cesargrobe/carrinho-robo/apresentacao_fecon_2026_16x9_v2.png

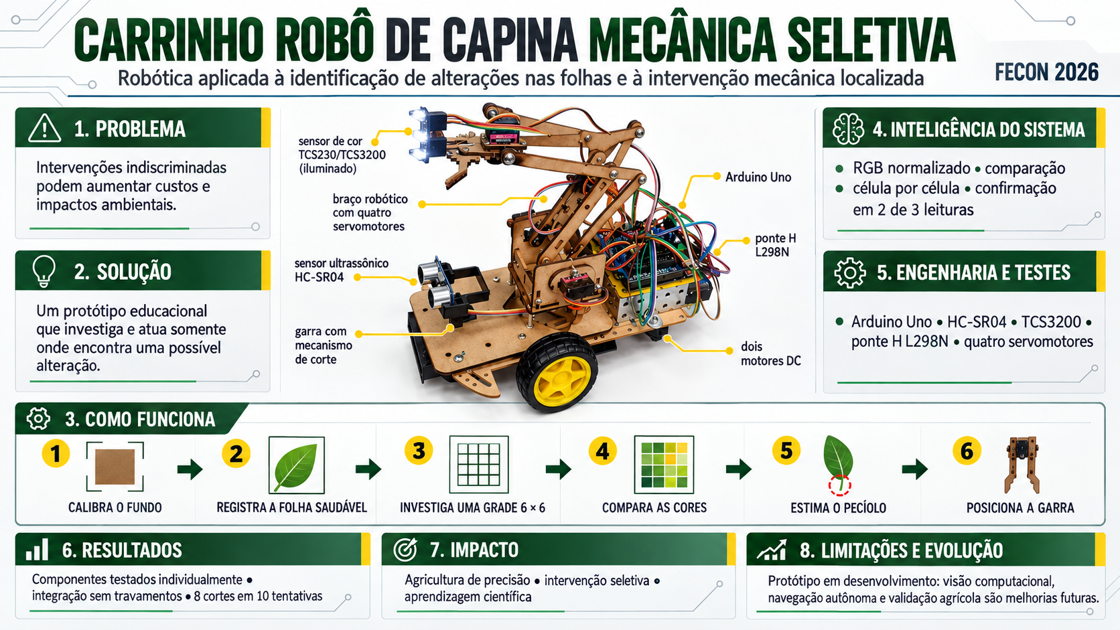
apresentacao_fecon_2026_16x9_v2.png
