cesargrobe/carrinho-robo/CALIBRACAO_BRACO_E_GRADE.xlsx

Sheet: Curva vertical
CALIBRAÇÃO DO BRAÇO E DA DISTÂNCIA DA GRADE
Ponto | Uso | Altura nominal (cm) | Altura medida (cm) | Distância 1 (cm) | Distância 2 (cm) | Distância 3 (cm) | Distância média (cm) | Erro de altura (cm) | Ombro nominal (°) | Ombro ajustado (°) | Cotovelo nominal (°) | Cotovelo ajustado (°) | Distância adequada? | Movimento seguro? | Observações
1 | Trajetória | 18.5 |  |  |  |  |  |  | 105 |  | 140
2 | Trajetória | 17.5 |  |  |  |  |  |  | 107 |  | 127
3 | Grade - linha 0 | 15 |  |  |  |  |  |  | 110 |  | 100
4 | Grade - linha 1 | 13 |  |  |  |  |  |  | 120 |  | 80
5 | Grade - linha 2 | 11 |  |  |  |  |  |  | 130 |  | 75
6 | Grade - linha 3 | 9 |  |  |  |  |  |  | 140 |  | 65
7 | Grade - linha 4 | 7 |  |  |  |  |  |  | 150 |  | 65
8 | Grade - linha 5 | 5 |  |  |  |  |  |  | 155 |  | 65
9 | Limite inferior | 2.5 |  |  |  |  |  |  | 165 |  | 40

Sheet: Grade horizontal
CALIBRAÇÃO HORIZONTAL DA GRADE 6 × 6
Coluna | Base nominal (°) | Base ajustada (°) | Posição horizontal medida (cm) | Observações
0 | 80
1 | 84
2 | 88
3 | 92
4 | 96
5 | 100

Sheet: Pecíolo
CALIBRAÇÃO DA POSE DE CORTE DO PECÍOLO
Tipo | Altura (cm) | Base (°) | Ombro (°) | Cotovelo (°) | Distância ao pecíolo (cm)
Estimativa atual | 16 | Calculada pela máscara | 109 | 111
Pose ajustada final
Resultado do fechamento / observações:

Sheet: Instruções
INSTRUÇÕES PARA PREENCHIMENTO
1. Confirme LM2596 em aproximadamente 7,0 V e anote a tensão das pilhas dos servos.
2. Mantenha a base em 90° nas medições verticais.
3. Use o mesmo plano fixo para medir a distância entre o TCS3200 e a folha.
4. Preencha somente as células amarelas.
5. Faça três medidas de distância em cada ponto; a média será automática.
6. Use os comandos 1 a 9 do código para percorrer a curva.
7. Registre qualquer tremor, esforço, colisão ou aproximação excessiva.
8. Para o pecíolo, use k, ajuste a pose, envie p e transcreva os ângulos.
9. Salve a planilha e devolva o mesmo arquivo para recalcularmos a curva.
Data
Responsável
Saída LM2596 (V)
Pilhas dos servos (V)
Distância desejada (cm)
